Szaborobert5/Electrical-Measuring-System/media/PCB_backside.png

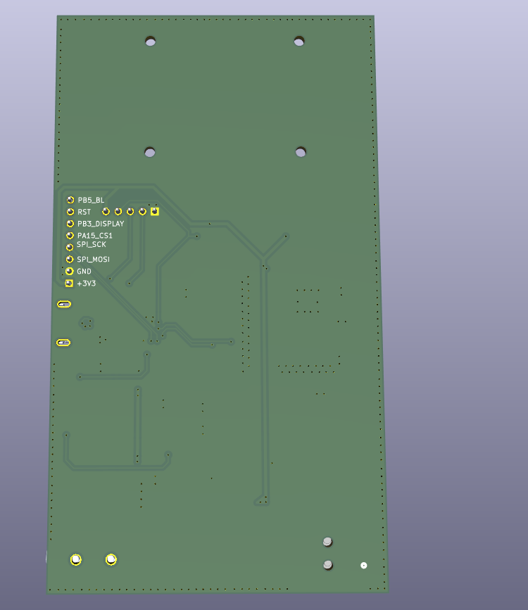
media/PCB_backside.png
