Szaborobert5/Electrical-Measuring-System/media/PCB_frontside.png

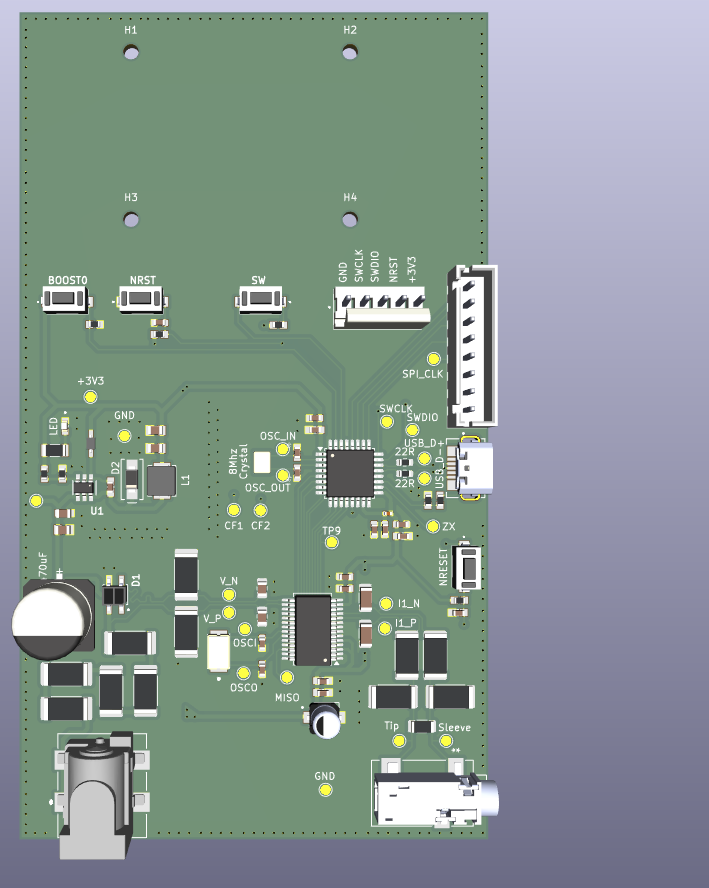
media/PCB_frontside.png
