Szaborobert5/Electrical-Measuring-System/main/PCB/Legatronics_project.csv

Reference | Qty | Value | Link | Description | Part number
C7,C12,C13,C26 | 4 | 10uF | https://www.digikey.com/en/products/detail/panasonic-industry/EEE-1CA100SR/766045,https://www.digikey.com/en/products/detail/taiyo-yuden/EMK212BJ106KG-T/930647 | 10uF electrolytic capacitor 16V,16V, 0805 | 587-1295-2-ND,PCE3878TR-ND
S1,S2,S3,S4 | 4 | PTS636_SM43J_SMTR_LFS | https://www.digikey.com/en/products/detail/c-k/PTS636SM43SMTR-LFS/10071723 | SWITCH TACTILE SPST-NO 0.05A 12V | 108-PTS636SM43SMTRLFSTR-ND
R14,R18,R19,R20,R21 | 5 | 3.6k | https://www.digikey.com/en/products/detail/bourns-inc/CR2512-JW-362ELF/3785999 | Resistor 3.6kOhms 1W | 118-CR2512-JW-362ELFTR-ND
C2,C11,C14,C17 | 4 | 1uF | https://www.digikey.com/en/products/detail/samsung-electro-mechanics/CL10B105KP8NNNC/3887604 | 1uF 10V 0603 | 1276-1946-2-ND
C22,C25 | 2 | 12p | https://www.digikey.com/en/products/detail/walsin-technology-corporation/0603N120J500CT/9354977 | 12p 50V 0603 | 1292-1480-2-ND
D1 | 1 | CBRHDSH2-40 TR13 PBFREE | https://www.digikey.com/en/products/detail/central-semiconductor-corp/CBRHDSH2-40-TR13-PBFREE/5212546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 | Bridge Rectifier Single Phase Schottky 40 V Surface Mount 4-HD DIP | 1514-CBRHDSH2-40TR13PBFREETR-ND
D5 | 1 | LED_screen | https://www.digikey.com/en/products/detail/seeed-technology-co-ltd/104990802/21526011 | Graphic LCD Display Module IPS (In-Plane Switching) SPI 1.69" (42.93mm) 280 x 240 | 1597-104990802-ND
D4 | 1 | LED | https://www.digikey.com/en/products/detail/liteon/LTST-C190KGKT/386815 | Light emitting diode, LTST-C190KGKT, Green 572nm LED Indication - Discrete 2.15V 0603 (1608 Metric) | 160-1435-2-ND
D3 | 1 | 1N4148WS | https://www.digikey.com/en/products/detail/onsemi/1N4148WS/1873805 | Diode Array 1 Independent 100 V 150mA Surface Mount | 1N4148WSFSTR-ND
FB1 | 1 | 120 | https://www.digikey.com/en/products/detail/laird-signal-integrity-products/MI0603M121R-10/806614 | Ferrite bead, 120Ohm | 240-2375-2-ND
R1,R3,R4,R6,R10 | 5 | 10k | https://www.digikey.com/en/products/detail/yageo/RC0603FR-0710KL/726880 | Resistor 10K OHM 1% 1/10W 0603 | 311-10.0KHRTR-ND
R9 | 1 | 62R | https://www.digikey.com/en/products/detail/yageo/RC1206FR-0762RL/729044 | Resistor, 0603, 1/4W | 311-62.0FRTR-ND
R23 | 1 | 82k | https://www.digikey.com/en/products/detail/yageo/RC0603JR-0782KL/726835 | Resistor 82K OHM 5% 1/10W 0603 | 311-82KGRTR-ND
C5,C8,C9,C23,C24,C27,Cboost1 | 7 | 100nF | https://www.digikey.com/en/products/detail/yageo/CC0603KRX7R7BB104/302822 | 16V, 0603,16V, 603 | 311-1088-2-ND
C18 | 1 | 1nF | https://www.digikey.com/en/products/detail/kemet/C0603C102K8RACTU/2199726 | 1nF 10V 0603 | 399-C0603C102K8RACTUTR-ND
C10 | 1 | 10nF | https://www.digikey.com/en/products/detail/kemet/C0603C103K8RACTU/2199758 | 10nF 10V 0603 | 399-C0603C103K8RACTUTR-ND
R17 | 1 | 51R | https://www.digikey.com/en/products/detail/susumu/HRG3216P-51R0-D-T1/5762534 | Resistor 51Ohms 1W | 408-1933-2-ND
C1,C3 | 2 | 8p | https://www.digikey.com/en/products/detail/tdk/C1608C0G1H080D080AA/2093311 | 8p 50V 0603 | 445-5043-2-ND
J5 | 1 | B8B-XH-A | https://www.digikey.com/en/products/detail/jst-sales-america-inc/B8B-XH-A/1651049 | Connector Header Through Hole 8 position 0.098" (2.50mm) | 455-B8B-XH-A-ND
C19,C20 | 2 | 33nF | https://www.digikey.com/en/products/detail/kyocera-avx/KGM21NR71H333JT/1116295 | 33nF 16V 0805 | 478-KGM21NR71H333JTTR-ND
C16,C21 | 2 | 330nF | https://www.digikey.com/en/products/detail/murata-electronics/GRM31C5C1E334JE01L/16033803 | 330nF 16V 1206 | 490-GRM31C5C1E334JE01LTR-ND
C4 | 1 | 470uF | https://www.digikey.com/en/products/detail/nichicon/UWT1C471MNL1GS/589922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 | 16V, 470uF, smd | 493-2181-2-ND
U2 | 1 | STM32G431K6Tx | https://www.digikey.com/en/products/detail/stmicroelectronics/STM32G431K6T6/18086046 | STMicroelectronics Arm Cortex-M4 MCU, 32KB flash, 32KB RAM, 170 MHz, 1.71-3.6V, 26 GPIO, LQFP32 | 497-STM32G431K6T6-ND
R24,R25 | 2 | 1k | https://www.digikey.com/en/products/detail/vishay-dale/CRCW25121K00FKEG/1173614 | Resistor SMD 1K OHM 1% 1W 2512 | 541-1.00KAFTR-ND
R12,R13 | 2 | 100R | https://www.digikey.com/en/products/detail/vishay-dale/CRCW2512100RFKEG/1173565 | Resistor 100ohms 1W | 541-100AFTR-ND
C6 | 1 | 4.7uF | https://www.digikey.com/en/products/detail/taiyo-yuden/LMK107BJ475KA-T/1004029 | 4.7uF 10V 0603 | 587-1441-2-ND
NDK–STDCRA3-8M1 | 1 | 8Mhz | https://www.digikey.com/en/products/detail/ndk-nihon-dempa-kogyo-co-ltd/STDCRA3-8M/3125637 | Crystal oscillator 8Mhz | 644-STDCRA3-8MTR-ND
J2 | 1 | Conn_01x05_Pin | https://www.digikey.com/en/products/detail/te-connectivity-amp-connectors/640456-5/259011 | Generic connector, single row, 01x05, script generated | A19471-ND
U3 | 1 | ATM90E26-YU | https://www.digikey.com/en/products/detail/microchip-technology/ATM90E26-YU-R/4899918 | High precision energy metering device for single-phase two-wire and single-phase three-wire, SSOP-28 | ATM90E26-YU-RTR-ND
D2 | 1 | B240 | https://www.digikey.com/en/products/detail/diodes-incorporated/B240A-13-F/717691 | 40V 2A Schottky Barrier Rectifier Diode, SMB | B240A-FDITR-ND
J3 | 1 | PJ-002AH-SMT-TR | https://www.digikey.com/en/products/detail/same-sky-formerly-cui-devices/PJ-002AH-SMT-TR/408452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 | Power Barrel Connector Jack 2.00mm ID (0.079"), 5.50mm OD (0.217") Surface Mount, Right Angle | CP-002AHPJTR-ND
J4 | 1 | SJ-3523-SMT-TR | https://www.digikey.com/en/products/detail/same-sky-formerly-cui-devices/SJ-3523-SMT-TR/281297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 | 3.50mm (0.141", 1/8", Mini Plug) - Headphone Phone Jack Stereo (3 Conductor, TRS) Connector Solder | CP-3523SJTR-ND
U1 | 1 | MCP16301x-xCH | https://www.digikey.com/en/products/detail/microchip-technology/MCP16301T-I-CHY/2696126 | 1A, 4.0 to 30V Input, High Voltage Input integrated switch step-down regulator, SOT-23-6 | MCP16301T-I/CHYTR-ND
R7,R8 | 2 | 22R | https://www.digikey.com/en/products/detail/panasonic-industry/ERJ-2RKF22R0X/1746157 | Resistor 22ohm 1/10W | P22.0LTR-ND
R22 | 1 | 33k | https://www.digikey.com/en/products/detail/panasonic-industry/ERA-3AEB333V/1465890 | Resistor 33K OHM 0.1% 1/10W 0603 | P33KDBTR-ND
R5 | 1 | 31.6k | https://www.digikey.ca/en/products/detail/stackpole-electronics-inc/RMCF0603FT31K6/1760794 | Resistor, 0603, 1/10W | RMCF0603FT31K6TR-ND
R15,R16 | 2 | 2R4 | https://www.digikey.com/en/products/detail/stackpole-electronics-inc/RMCF2512JT24K0/1757029 | Resistor 24kOhms 1W | RMCF2512JT24K0TR-ND
L1 | 1 | 15uH | https://www.digikey.com/en/products/detail/bourns-inc/SRP4020TA-150M/4901000 | 15 µH Shielded Drum Core, Wirewound Inductor 1.5 A 374mOhm Max 2-SMD | SRP4020TA-150MTR-ND
J1 | 1 | USB-B-1051640001 | https://www.digikey.com/en/products/detail/molex/1051640001/4555286 | USB - micro B USB 2.0 Receptacle Connector 5 Position Surface Mount, Right Angle; Through Hole | WM11263TR-ND
ECS-81.92-12-30Q-EN-TR1 | 1 | 8,192MHz | https://www.digikey.com/en/products/detail/ecs-inc/ECS-81-92-12-30Q-EN-TR/10239110 | 8.192 MHz ±30ppm Crystal 12pF 100 Ohms 2-SMD, No Lead | XC3145TR-ND
