Szaborobert5/Electrical-Measuring-System/main/PCB/Legatronics_project.kicad_pcb

## KiCad design main/PCB/Legatronics_project.kicad_pcb (2026-10-29)

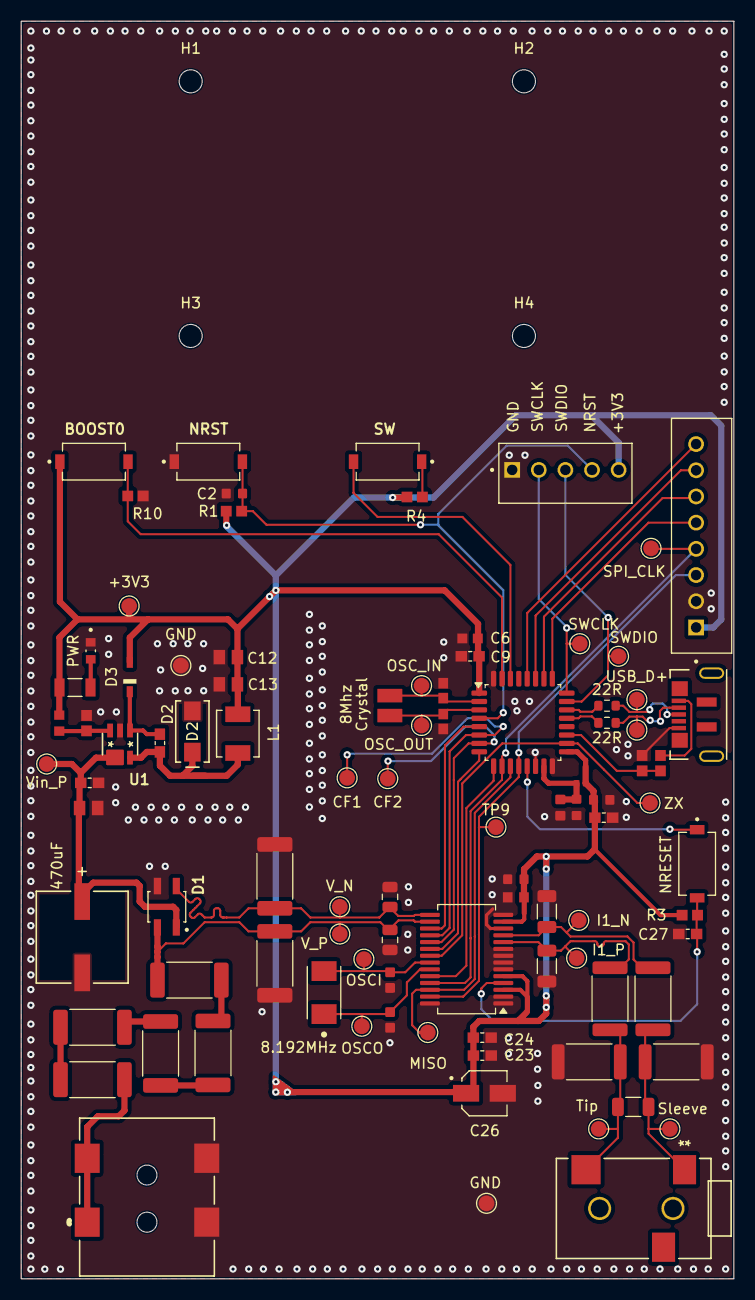
[picture p8: board Legatronics_project.kicad_pcb from above]

Board: 2 copper layers, 68.0 x 120.0 mm, 98 parts (0 on the bottom side), 50 nets.

Parts:
+3V3: 3V3; TestPoint_Pad_D1.5mm
C1, C3: 8p; CAPC1608X90N
C2, C11, C14, C17: 1uF; CAPC1608X90N
C4: 470uF; PCAP_8x10-ELECT_NCA
C5, C8, C9, C23, C24, C27: 100nF; CAPC1608X90
C6: 4.7uF; CAPC1608X90N
C7, C12, C13: 10uF; CAPC2012X135N
C10: 10nF; CAPC1608X90N
C16, C21: 330nF; C_1206_3216Metric
C18: 1nF; CAPC1608X90N
C19, C20: 33nF; C_0805_2012Metric
C22, C25: 12p; CAPC1608X87N
C26: 10uF; CAP_EEE1CA100SR
CF1: CF1; TestPoint_Pad_D1.5mm
CF2: CF2; TestPoint_Pad_D1.5mm
Cboost1: 100nF; CAPC1608X90
D1: CBRHDSH2-40 TR13 PBFREE; SOIC180P460X187-4N
D2: B240; SMA_DIO-L
D3: 1N4148WS; SODFL2512X100N
D4: PWR; LEDC1608X35N
ECS-81.92-12-30Q-EN-TR1: 8.192MHz; XTAL_ECS-81.92-12-30Q-EN-TR
FB1: 120; BEADC1005X55N
GND: GND; TestPoint_Pad_D1.5mm
GND#2: GND; TestPoint_Pad_D1.5mm
H1, H2, H3, H4: MountingHole; MountingHole_2.2mm_M2
J1: USB-B-1051640001; CON00906_5_MOL
J2: Conn_01x05_Pin; TE_640456-5
J3: PJ-002AH-SMT-TR; PJ-002AH-SMT-TR_CUD
J4: SJ-3523-SMT-TR; SJ-3523-SMT_CUD
J5: B8B-XH-A; JST_B8B-XH-A
L1: 15uH; IND_SRP4020TA-150M
MISO: MISO; TestPoint_Pad_D1.5mm
NDK–STDCRA3-8M1: 8Mhz; XTAL_NX3225GD-8MHZ-STD-CRA-3_NDK
NRESET: PTS636_SM43J_SMTR_LFS; SW_PTS636_SM43J_SMTR_LFS
OSCI: OSCI; TestPoint_Pad_D1.5mm
OSCO: OSCO; TestPoint_Pad_D1.5mm
OSC_IN: OSC_IN; TestPoint_Pad_D1.5mm
OSC_OUT: OSC_OUT; TestPoint_Pad_D1.5mm
R1, R3, R4, R6, R10: 10k; RESC1607X60N
R5: 31.6k; RESC1508X55N
R7, R8: 22R; R_0603_1608Metric
R9: 62R; RESC3116X65N
R12, R13: 100R; R_2512_6332Metric
R14, R18, R19, R20, R21: 3.6k; R_2512_6332Metric_Pad1.40x3.35mm_HandSolder
R15, R16: 2R4; R_2512_6332Metric
R17: 51R; R_1206_3216Metric
R22: 33k; RESC1607X60N
R23: 82k; RESC1607X60N
R24, R25: 1k; R_2512_6332Metric_Pad1.40x3.35mm_HandSolder
S1, S2, S4: PTS636_SM43J_SMTR_LFS; SW_PTS636_SM43J_SMTR_LFS
SPI_CLK: SPI_SCK; TestPoint_Pad_D1.5mm
SWCLK: SWCLK; TestPoint_Pad_D1.5mm
SWDIO: SWDIO; TestPoint_Pad_D1.5mm
Sleeve: Sleeve; TestPoint_Pad_D1.5mm
TP3: I1_P; TestPoint_Pad_D1.5mm
TP4: I1_N; TestPoint_Pad_D1.5mm
TP9: MOSI; TestPoint_Pad_D1.5mm
TP22: Vin_P; TestPoint_Pad_D1.5mm
Tip: Tip; TestPoint_Pad_D1.5mm
U1: MCP16301x-xCH; SOT-23-6_MC_MCH
U2: STM32G431K6Tx; LQFP-32_7x7mm_P0.8mm
U3: ATM90E26-YU; SSOP-28_5.3x10.2mm_P0.65mm
USB_D+: USB_D+; TestPoint_Pad_D1.5mm
USB_D-: USB_D-; TestPoint_Pad_D1.5mm
V_N: IN2_N; TestPoint_Pad_D1.5mm
V_P: V_P; TestPoint_Pad_D1.5mm
ZX: ZX; TestPoint_Pad_D1.5mm

Connections:
+3V3: +3V3.1 (1_1), C6.1, C8.1, C9.1, C12.1, C13.1, C14.1, C17.1, C18.1, C23.1, C24.1, C26.1, D3.A, FB1.2, J2.5, J5.1, L1.2, R1.1, R3.2, R4.1, R5.1, R9.1, S2.1, U2.1 (VDD), U2.17 (VDD), U3.3 (DVDD), U3.5 (AVDD), U3.13 (Vref)
/BOOT0: R10.2, S2.2, U2.31 (PB8)
/Boost: Cboost1.1, D3.C, U1.1 (BOOST)
/CF1: CF1.1 (1_1), U2.6 (PA1), U3.18 (CF1)
/CF2: CF2.1 (1_1), U2.7 (PA2), U3.19 (CF2)
/CS2: U2.9 (PA4), U3.24 (~CS)
/I1_N: C16.2, R13.2, TP4.1 (1_1), U3.11 (I1N)
/I1_P: C21.1, R12.2, TP3.1 (1_1), U3.10 (I1P)
/IRQ: U2.8 (PA3), U3.20 (IRQ)
/LED_A: D4.2, R9.2
/NRESET: NRESET.1, U2.13 (PB0)
/NRST: C2.1, J2.4, R1.2, S1.2, U2.4 (PG10)
/OSCI: C25.1, ECS-81.92-12-30Q-EN-TR1.2, OSCI.1 (1_1), U3.22 (OSCI)
/OSCO: C22.1, ECS-81.92-12-30Q-EN-TR1.1, OSCO.1 (1_1), U3.23 (OSCO)
/OSC_IN: C3.1, NDK–STDCRA3-8M1.2, OSC_IN.1 (1_1), U2.2 (PF0)
/OSC_OUT: C1.1, NDK–STDCRA3-8M1.1, OSC_OUT.1 (1_1), U2.3 (PF1)
/PA9_USB: R22.2, R23.1, U2.19 (PA9)
/PA15_CS1: J5.5, U2.25 (PA15)
/PB3_DISPLAY: J5.6, U2.26 (PB3)
/PB4_RST: J5.7, U2.27 (PB4)
/PB5_BL: J5.8, U2.28 (PB5)
/PB7_SW2: S4.2, U2.30 (PB7)
/SPI_MISO: MISO.1 (1_1), U2.11 (PA6), U3.26 (SDO/UTX)
/SPI_MOSI: J5.3, TP9.1 (1_1), U2.12 (PA7), U3.27 (SDI/URX)
/SPI_SCK: J5.4, SPI_CLK.1 (1_1), U2.10 (PA5), U3.25 (SCLK)
/SW: Cboost1.2, D2.1 (K), L1.1, U1.6 (SW)
/SWCLK: J2.2, SWCLK.1 (1_1), U2.24 (PA14)
/SWDIO: J2.3, SWDIO.1 (1_1), U2.23 (PA13)
/Sleeve: J4.1 (SLEEVE), R13.1, R16.1, R17.1, Sleeve.1 (1_1)
/Tip: J4.2 (TIP), R12.1, R15.2, R17.2, Tip.1 (1_1)
/USB_D+: J1.3, R8.2, USB_D+.1 (1_1)
/USB_D-: J1.2, R7.2, USB_D-.1 (1_1)
/VBUS: J1.1, R22.1
/VDDA: C10.1, C11.1, FB1.1, U2.15 (VDDA)
/VIn_P: C4.1, C5.1, C7.1, D1.1 (+), TP22.1 (1_1), U1.4 (EN), U1.5 (V_{IN})
/V_N: C20.1, D1.2, R25.2, U3.15 (VN), V_N.1 (1_1)
/V_P: C19.1, D1.4, R21.2, R24.2, U3.16 (VP), V_P.1 (1_1)
/Vfb: R5.2, R6.1, U1.3 (Vfb)
/WO: U2.5 (PA0), U3.17 (WarnOut)
/ZX: U2.18 (PA8), U3.21 (ZX), ZX.1 (1_1)
/uC_D+: R8.1, U2.22 (PA12)
/uC_D-: R7.1, U2.21 (PA11)
GND: C1.2, C2.2, C3.2, C4.2, C5.2, C6.2, C7.2, C8.2, C9.2, C10.2, C11.2, C12.2, C13.2, C14.2, C16.1, C17.2, C18.2, C19.2, C20.2, C21.2, C22.2, C23.2, C24.2, C25.2, C26.2, C27.2, D1.3 (-), D2.2 (A), D4.1, GND.1 (1_1), GND#2.1 (1_1), J1.5, J2.1, J3.2, J3.3, J5.2, R6.2, R10.1, R15.1, R16.2, R23.2, R24.1, R25.1, S1.1, U1.2 (GND), U2.14 (VSSA), U2.16 (VSS), U2.32 (VSS), U3.1 (MMD1), U3.2 (DGND), U3.6 (AGND), U3.7 (I2P), U3.8 (I2N), U3.9 (DGND), U3.12 (USEL), U3.14 (AGND), U3.28 (MMD0)
unnamed: J3.1A, J3.1B, R14.1
unnamed: R4.2, S4.1
unnamed: R14.2, R18.1
unnamed: R18.2, R19.1
unnamed: R19.2, R20.1
unnamed: R20.2, R21.1
unnamed: C27.1, NRESET.2, R3.1, U3.4 (~Reset)
