Szaborobert5/Electrical-Measuring-System/Display_Screens/Core/Src/main.c

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
/* Includes ------------------------------------------------------------------*/
#include "main.h"

/* USER CODE BEGIN Includes */
#include "tests.h"
#include "st7789.h"
#include "screens.h"
#include "atm90e26.h"

/* USER CODE END Includes */

/* USER CODE BEGIN PD */
#define BTN_DEBOUNCE_MS  50
/* USER CODE END PD */

SPI_HandleTypeDef hspi1;

/* USER CODE BEGIN PV */
static uint8_t  _btn_last    = 1;   /* last stable GPIO level (idle=1 pull-up) */
static uint32_t _btn_time    = 0;
/* USER CODE END PV */

void SystemClock_Config(void);
static void MX_GPIO_Init(void);
static void MX_SPI1_Init(void);
/* USER CODE BEGIN 0 */


/* Helpers */
static void Button_Poll(void);
/* USER CODE END 0 */

/**
  * @brief  The application entry point.
  * @retval int
  */
int main(void)
{

  /* MCU Configuration--------------------------------------------------------*/

  /* Reset of all peripherals, Initializes the Flash interface and the Systick. */
  HAL_Init();

  /* Configure the system clock */
  SystemClock_Config();

  /* Initialize all configured peripherals */
  MX_GPIO_Init();
  MX_SPI1_Init();
  /* USER CODE BEGIN 2 */
  ST7789_Init();
  HAL_GPIO_WritePin(BL_ST7789_GPIO_Port, BL_ST7789_Pin, GPIO_PIN_SET);
  Screens_Init();
  ATM_Init();

	/*EnergyData_t data = {
			.voltage        = 233.8f,
			.current        = 7.327f,
			.active_power   = 1994.2f,
			.reactive_power = 121.3f,
			.apparent_power = 1001.6f,
			.power_factor   = 0.993f,
			.frequency      = 50.01f,
			.energy_wh      = 8284.7f,
			.v_min          = 224.2f,
			.v_max          = 234.6f,
			.i_min          = 0.21f,
			.i_max          = 8.40f,
			.p_min          = 0.0f,
			.p_max          = 2100.0f,
			.session_sec    = 4663,
		};*/

    uint32_t last_read_ms = 0;
  /* USER CODE END 2 */

  /* Infinite loop */
  /* USER CODE BEGIN WHILE */
  while (1)
  {
	  //ST7789_FillColor(BLACK);

	  //Test_SPI_Comms();
	  //HAL_Delay(5000);
	  //Run_Tests();
	  uint32_t now = HAL_GetTick();

	  	  Button_Poll();

	  	  if ((now - last_read_ms) >= 500)
	  	  {
	  		  ATM_ReadAll();
	  		  Screens_UpdateStats(&g_energy);
	  		  g_energy.session_sec += (now - last_read_ms) / 1000;
	  		  last_read_ms = now;
	  		  Screens_Update(&g_energy);
	  	  }

    /* USER CODE END WHILE */

    /* USER CODE BEGIN 3 */
  }
  /* USER CODE END 3 */
}

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
/* USER CODE BEGIN 4 */

/* ════════════════════════════════════════════════════════════════════
   BUTTON POLLING
   Reads SW2 on PB7 (active-LOW, internal pull-up).
   On each falling edge (press), advances to the next screen.
   Screens cycle: VOLTAGE → CURRENT → POWER → ENERGY → VOLTAGE ...
   ════════════════════════════════════════════════════════════════════ */
static void Button_Poll(void)
{
    uint8_t  level = HAL_GPIO_ReadPin(SW2_GPIO_Port, SW2_Pin);
    uint32_t now   = HAL_GetTick();

    /* Detect falling edge (idle HIGH → pressed LOW) */
    if (_btn_last == 1 && level == GPIO_PIN_RESET)
    {
        /* Debounce: ignore edges within 50 ms of the last one */
    	if ((now - _btn_time) >= BTN_DEBOUNCE_MS)
        {
            _btn_time = now;
            Screens_NextState();          /* advance screen */
            Screens_Update(&g_energy);    /* immediate redraw */
        }
    }
    _btn_last = level;
}


/* USER CODE END 4 */
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
