Szaborobert5/Electrical-Measuring-System/Display_Screens/Display_Screens.ioc

Mcu.UserName=STM32G431K8Tx
PA0.GPIO_Label=WarnOut
PA0.Signal=GPIO_Input
PA1.GPIO_Label=CF1
PA1.Signal=GPIO_Input
PA13.Signal=SYS_JTMS-SWDIO
PA14.Signal=SYS_JTCK-SWCLK
PA15.GPIO_Label=CS_ST7789
PA15.Signal=GPIO_Output
PA2.GPIO_Label=CF2
PA2.Signal=GPIO_Input
PA3.GPIO_Label=IRQ
PA3.Signal=GPIO_Input
PA4.GPIO_Label=CS_ATM90E26
PA4.Signal=GPIO_Output
PA5.Signal=SPI1_SCK
PA6.Signal=SPI1_MISO
PA7.Signal=SPI1_MOSI
PA8.GPIO_Label=ZX
PA8.Signal=GPIO_Input
PB0.GPIO_Label=Reset_ATM
PB0.Signal=GPIO_Output
PB3.GPIO_Label=DC_ST7789
PB3.Signal=GPIO_Output
PB4.GPIO_Label=Reset_ST7789
PB4.Signal=GPIO_Output
PB5.GPIO_Label=BL_ST7789
PB5.Signal=GPIO_Output
PB7.GPIO_Label=SW2
PB7.Signal=GPIO_Input
PF0-OSC_IN.Signal=RCC_OSC_IN
PF1-OSC_OUT.Signal=RCC_OSC_OUT
