Szaborobert5/Electrical-Measuring-System/Display_Screens/Core/Inc/main.h

#define WarnOut_Pin GPIO_PIN_0
#define WarnOut_GPIO_Port GPIOA
#define CF1_Pin GPIO_PIN_1
#define CF1_GPIO_Port GPIOA
#define CF2_Pin GPIO_PIN_2
#define CF2_GPIO_Port GPIOA
#define IRQ_Pin GPIO_PIN_3
#define IRQ_GPIO_Port GPIOA
#define CS_ATM90E26_Pin GPIO_PIN_4
#define CS_ATM90E26_GPIO_Port GPIOA
#define Reset_ATM_Pin GPIO_PIN_0
#define Reset_ATM_GPIO_Port GPIOB
#define ZX_Pin GPIO_PIN_8
#define ZX_GPIO_Port GPIOA
#define CS_ST7789_Pin GPIO_PIN_15
#define CS_ST7789_GPIO_Port GPIOA
#define DC_ST7789_Pin GPIO_PIN_3
#define DC_ST7789_GPIO_Port GPIOB
#define Reset_ST7789_Pin GPIO_PIN_4
#define Reset_ST7789_GPIO_Port GPIOB
#define BL_ST7789_Pin GPIO_PIN_5
#define BL_ST7789_GPIO_Port GPIOB
#define SW2_Pin GPIO_PIN_7
#define SW2_GPIO_Port GPIOB
